JordanAceto/stereo_modulation_fx_motherboard/construction_docs/BOM.ods

Reference | Quantity | Value | Footprint | Unit Price | Total Price | Product Page
Mouser Parts
C14 C13 C12 C11 C10 C19 C18 C17 C16 C15 C22 C24 C23 C25 C20 C21 C29 C28 C39 C8 C9 C32 C33 C35 C36 C40 C41 C42 C7 C34 C43 C44 C45 | 33 | 100nF | 0805 | $0.10 | $3.30 | https://www.mouser.com/ProductDetail/KEMET/C0805C104M5RACTU
C30 C31 | 2 | 100nF | 0805 | $0.66 | $1.32 | https://www.mouser.com/ProductDetail/Panasonic/ECP-U1C104MA5
C1 C2 C3 C4 | 4 | 1uF | 0805 | $0.44 | $1.76 | https://www.mouser.com/ProductDetail/KEMET/C0805C105M5RACTU
C27 C26 C37 C38 | 4 | 10nF | 0805 | $0.30 | $1.20 | https://www.mouser.com/ProductDetail/KEMET/C0805C103J5GEC7210
C46 C47 | 2 | 22uF | 0805 | $0.66 | $1.32 | https://www.mouser.com/ProductDetail/Murata-Electronics/GRT21BR61E226ME13L
C5 C6 | 2 | 4u7 | 0805 | $0.22 | $0.44 | https://www.mouser.com/ProductDetail/TDK/C2012X7R1A475M125AC
D1 D2 | 1 | NeoPixel_THT (5 pack) | 5MM LED | $4.95 | $4.95 | https://www.mouser.com/ProductDetail/Adafruit/1938
J9 J10 J11 J12 J13 J14 | 1 | breakaway headers X 40 | PinHeader_2.54mm | $2.78 | $2.78 | https://www.mouser.com/ProductDetail/TE-Connectivity/4-103185-0
J1 J2 J3 J4 J5 J6 J7 J8 | 3 | breakaway sockets X 30 | PinSocket 2.54mm | $4.50 | $13.50 | https://www.mouser.com/ProductDetail/TE-Connectivity-AMP/7-535541-8
L2 L3 | 2 | 100uH | 0805 | ? | #VALUE!
L1 | 1 | 100uH | 0805 | ? | #VALUE!
R1 R2 | 2 | 100k | 0805 | $0.10 | $0.20 | https://www.mouser.com/ProductDetail/Bourns/CR0805-FX-1003ELF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
R11 R12 | 2 | 30k | 0805 | $0.10 | $0.20 | https://www.mouser.com/ProductDetail/Bourns/CR0805-FX-3002ELF
R13 R14 | 2 | 120k | 0805 | $0.10 | $0.20 | https://www.mouser.com/ProductDetail/Bourns/CR0805-FX-1203ELF
R15 R16 | 2 | 82k | 0805 | $0.12 | $0.24 | https://www.mouser.com/ProductDetail/Bourns/CR0805-FX-8202ELF
R17 | 1 | 15k | 0805 | $0.10 | $0.10 | https://www.mouser.com/ProductDetail/Bourns/CR0805-FX-1502ELF
R18 | 1 | 27k | 0805 | $0.10 | $0.10 | https://www.mouser.com/ProductDetail/Bourns/CR0805-FX-2702ELF
R21 R22 | 2 | 2k2 | 0805 | $0.10 | $0.20 | https://www.mouser.com/ProductDetail/Bourns/CR0805-FX-2201ELF
R3 R4 | 2 | 20k | 0805 | $0.10 | $0.20 | https://www.mouser.com/ProductDetail/Bourns/CR0805-FX-2002ELF
R6 R5 | 2 | 1M | 0805 | $0.10 | $0.20 | https://www.mouser.com/ProductDetail/Bourns/CR0805-FX-1004ELF
R7 R8 | 2 | 220 | 0805 | $0.10 | $0.20 | https://www.mouser.com/ProductDetail/Bourns/CR0805-FX-2200ELF
R9 R10 | 2 | 10k | 0805 | $0.10 | $0.20 | https://www.mouser.com/ProductDetail/Bourns/CR0805-FX-1002ELF
RV13 RV14 | 2 | 100k | Bourns_3269W_Vertical | $4.83 | $9.66 | https://www.mouser.com/ProductDetail/Bourns/3269W-1-104LF?qs=sGAEpiMZZMvygUB3GLcD7iPUMwpiXMBsQtXtzdbyTwg%3D
SW1 | 1 | sweep_mode_center_off | SPDT_on_off_on | $2.70 | $2.70 | https://www.mouser.com/ProductDetail/E-Switch/100SP3T1B1M2QEH
SW2 | 1 | invert_B | SPDT_on_on | $2.24 | $2.24 | https://www.mouser.com/ProductDetail/E-Switch/100SP1T1B1M2QEH
SW3 | 1 | B_input_selector_on_on_on | DPDT_on_on_on | $4.01 | $4.01 | https://www.mouser.com/ProductDetail/E-Switch/100DP6T1B1M2QE?qs=sGAEpiMZZMvudeGI7i40XLGgXAXfCfEjq1FnpdPcT88%3D
U1 | 1 | Teensy3.2 | teensy_3.2 | $24.93 | $24.93 | https://www.mouser.com/ProductDetail/Adafruit/2756
U10 U11 | 2 | DG419LDY | SOIC-8 | $3.88 | $7.76 | https://www.mouser.com/ProductDetail/Maxim-Integrated/DG419LDY%2B
U2 | 1 | CD74HC4067M | SOIC-24W | $0.93 | $0.93 | https://www.mouser.com/ProductDetail/Texas-Instruments/CD74HC4067M
U3 U4 | 2 | MCP4822 | SOIC-8 | $3.09 | $6.18 | https://www.mouser.com/ProductDetail/Microchip-Technology/MCP4822-E-SN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
U5 U7 | 2 | TL072 | SOIC-8 | $0.60 | $1.20 | https://www.mouser.com/ProductDetail/Texas-Instruments/TL072CDR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
U8 U6 U12 | 3 | MCP6002 | SOIC-8 | $0.33 | $0.99 | https://www.mouser.com/ProductDetail/Microchip-Technology/MCP6002T-I-SN
U9 | 1 | CC3-0512DF-E | CC3-0512DF-E | $11.21 | $11.21 | https://www.mouser.com/ProductDetail/TDK-Lambda/CC3-0512DF-E
 |  |  | Mouser Total: |  | #VALUE!
 |  |  | Link to Mouser project:
Non-Mouser Parts
RV1 RV3 RV5 RV9 RV2 RV4 RV6 RV10 | 8 | 10k linear | Alpha_RD901F-40-00D | $1.61 | $12.88 | https://www.thonk.co.uk/shop/alpha-9mm-pots/
R7 R8 RV11 RV12 | 4 | 10k linear with center detent | Alpha_RD901F-40-00D | $1.64 | $6.56 | https://www.thonk.co.uk/shop/alpha-9mm-pots/
 |  |  | Non-Mouser total: |  | $19.44
OSHPark Board
[add link here when happy with board]
