JordanAceto/stereo_modulation_fx_motherboard/construction_docs/parts_list.ods

Reference | Quantity | Value
C14 C13 C12 C11 C10 C19 C18 C17 C16 C15 C22 C24 C23 C25 C20 C21 C29 C28 C39 C8 C9 C32 C33 C35 C36 C40 C41 C42 C7 C34 C43 C44 C45 | 33 | 100nF
C30 C31 | 2 | 100nF
C1 C2 C3 C4 | 4 | 1uF
C27 C26 C37 C38 | 4 | 10nF
C46 C47 | 2 | 22uF
C5 C6 | 2 | 4u7
D1 D2 | 1 | NeoPixel_THT (5 pack)
J9 J10 J11 J12 J13 J14 | 1 | breakaway headers X 40
J1 J2 J3 J4 J5 J6 J7 J8 | 3 | breakaway sockets X 30
L2 L3 | 2 | 100uH
L1 | 1 | 100uH
R1 R2 | 2 | 100k
R11 R12 | 2 | 30k
R13 R14 | 2 | 120k
R15 R16 | 2 | 82k
R17 | 1 | 15k
R18 | 1 | 27k
R21 R22 | 2 | 2k2
R3 R4 | 2 | 20k
R6 R5 | 2 | 1M
R7 R8 | 2 | 220
R9 R10 | 2 | 10k
RV13 RV14 | 2 | 100k
SW1 | 1 | sweep_mode_center_off
SW2 | 1 | invert_B
SW3 | 1 | B_input_selector_on_on_on
U1 | 1 | Teensy3.2
U10 U11 | 2 | DG419LDY
U2 | 1 | CD74HC4067M
U3 U4 | 2 | MCP4822
U5 U7 | 2 | TL072
U8 U6 U12 | 3 | MCP6002
U9 | 1 | CC3-0512DF-E
RV1 RV3 RV5 RV9 RV2 RV4 RV6 RV10 | 8 | 10k linear
R7 R8 RV11 RV12 | 4 | 10k linear with center detent
