JordanAceto/stereo_modulation_fx_motherboard/(threads)

Thread 1 (2019-07-18):

B-input switch is backwards on pcb

JordanAceto, 2019-07-18:
DPDT on-on-on switch is mirrored vertically on pcb.

to fix: change footprint in .pretty file and re-route pcb

Thread 2 (2019-07-18):

all pots are backwards on pcb

JordanAceto, 2019-07-18:
All pots reach +3.3v at full CCW and 0v at full CW.

This is currently accounted for in the firmware by inverting all of the pot signals as they are read by the ADC, but it would be nice to have them go the right way in a future board rev.

To fix: flip all the pots in the schematic and re-route the pcb.

Thread 3 (2019-07-18):

The silkscreen for env A trim and env B trim are reversed

JordanAceto, 2019-07-18:
To fix: swap the silkscreen notes on the pcb

Thread 4 (2019-07-18):

The silkscreen for L3 and C25 reversed

JordanAceto, 2019-07-18:
This is a bad issue. If the board is build according to the silkscreen the -12v rail will be shorted to ground through L3.

To fix: swap the silkscreen designators on the pcb.

Thread 5 (2019-07-18):

footprints for all inductors are wrong

JordanAceto, 2019-07-18:
The footprints for all the inductors do not match the inductors in the BOM. Power filtering needs to be improved in general.

On the current board 600 ohm ferrite beads are installed @ L1, L2, and L3.
