JordanAceto/stereo_modulation_fx_motherboard/construction_docs/schematic.pdf

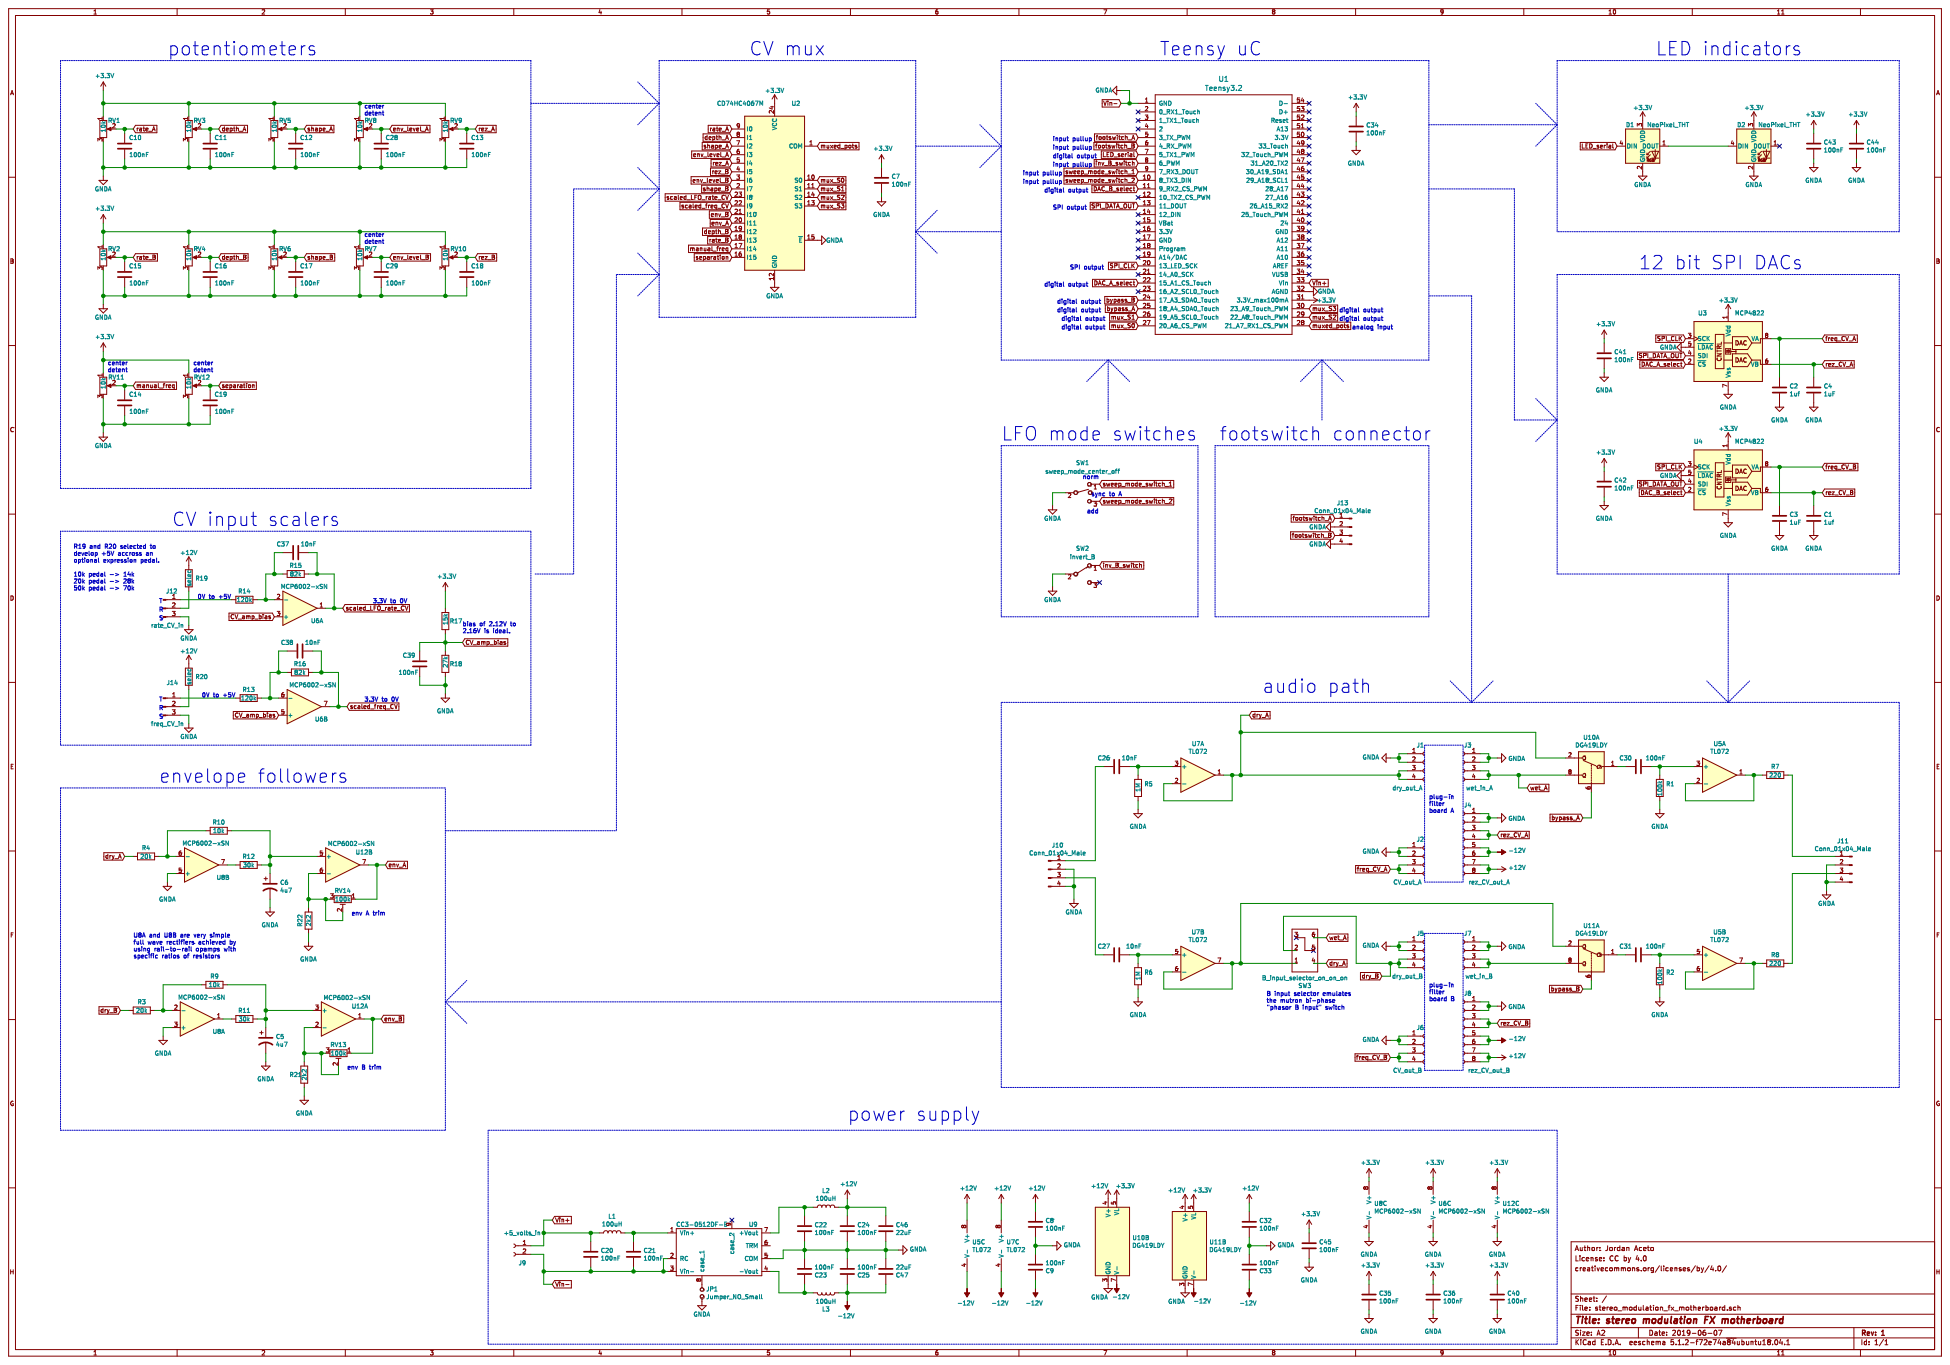
[picture p1: page 1]
