JordanAceto/stereo_modulation_fx_motherboard/kicad_docs/stereo_modulation_fx_motherboard.kicad_pcb

## KiCad design kicad_docs/stereo_modulation_fx_motherboard.kicad_pcb (2019-06-21)

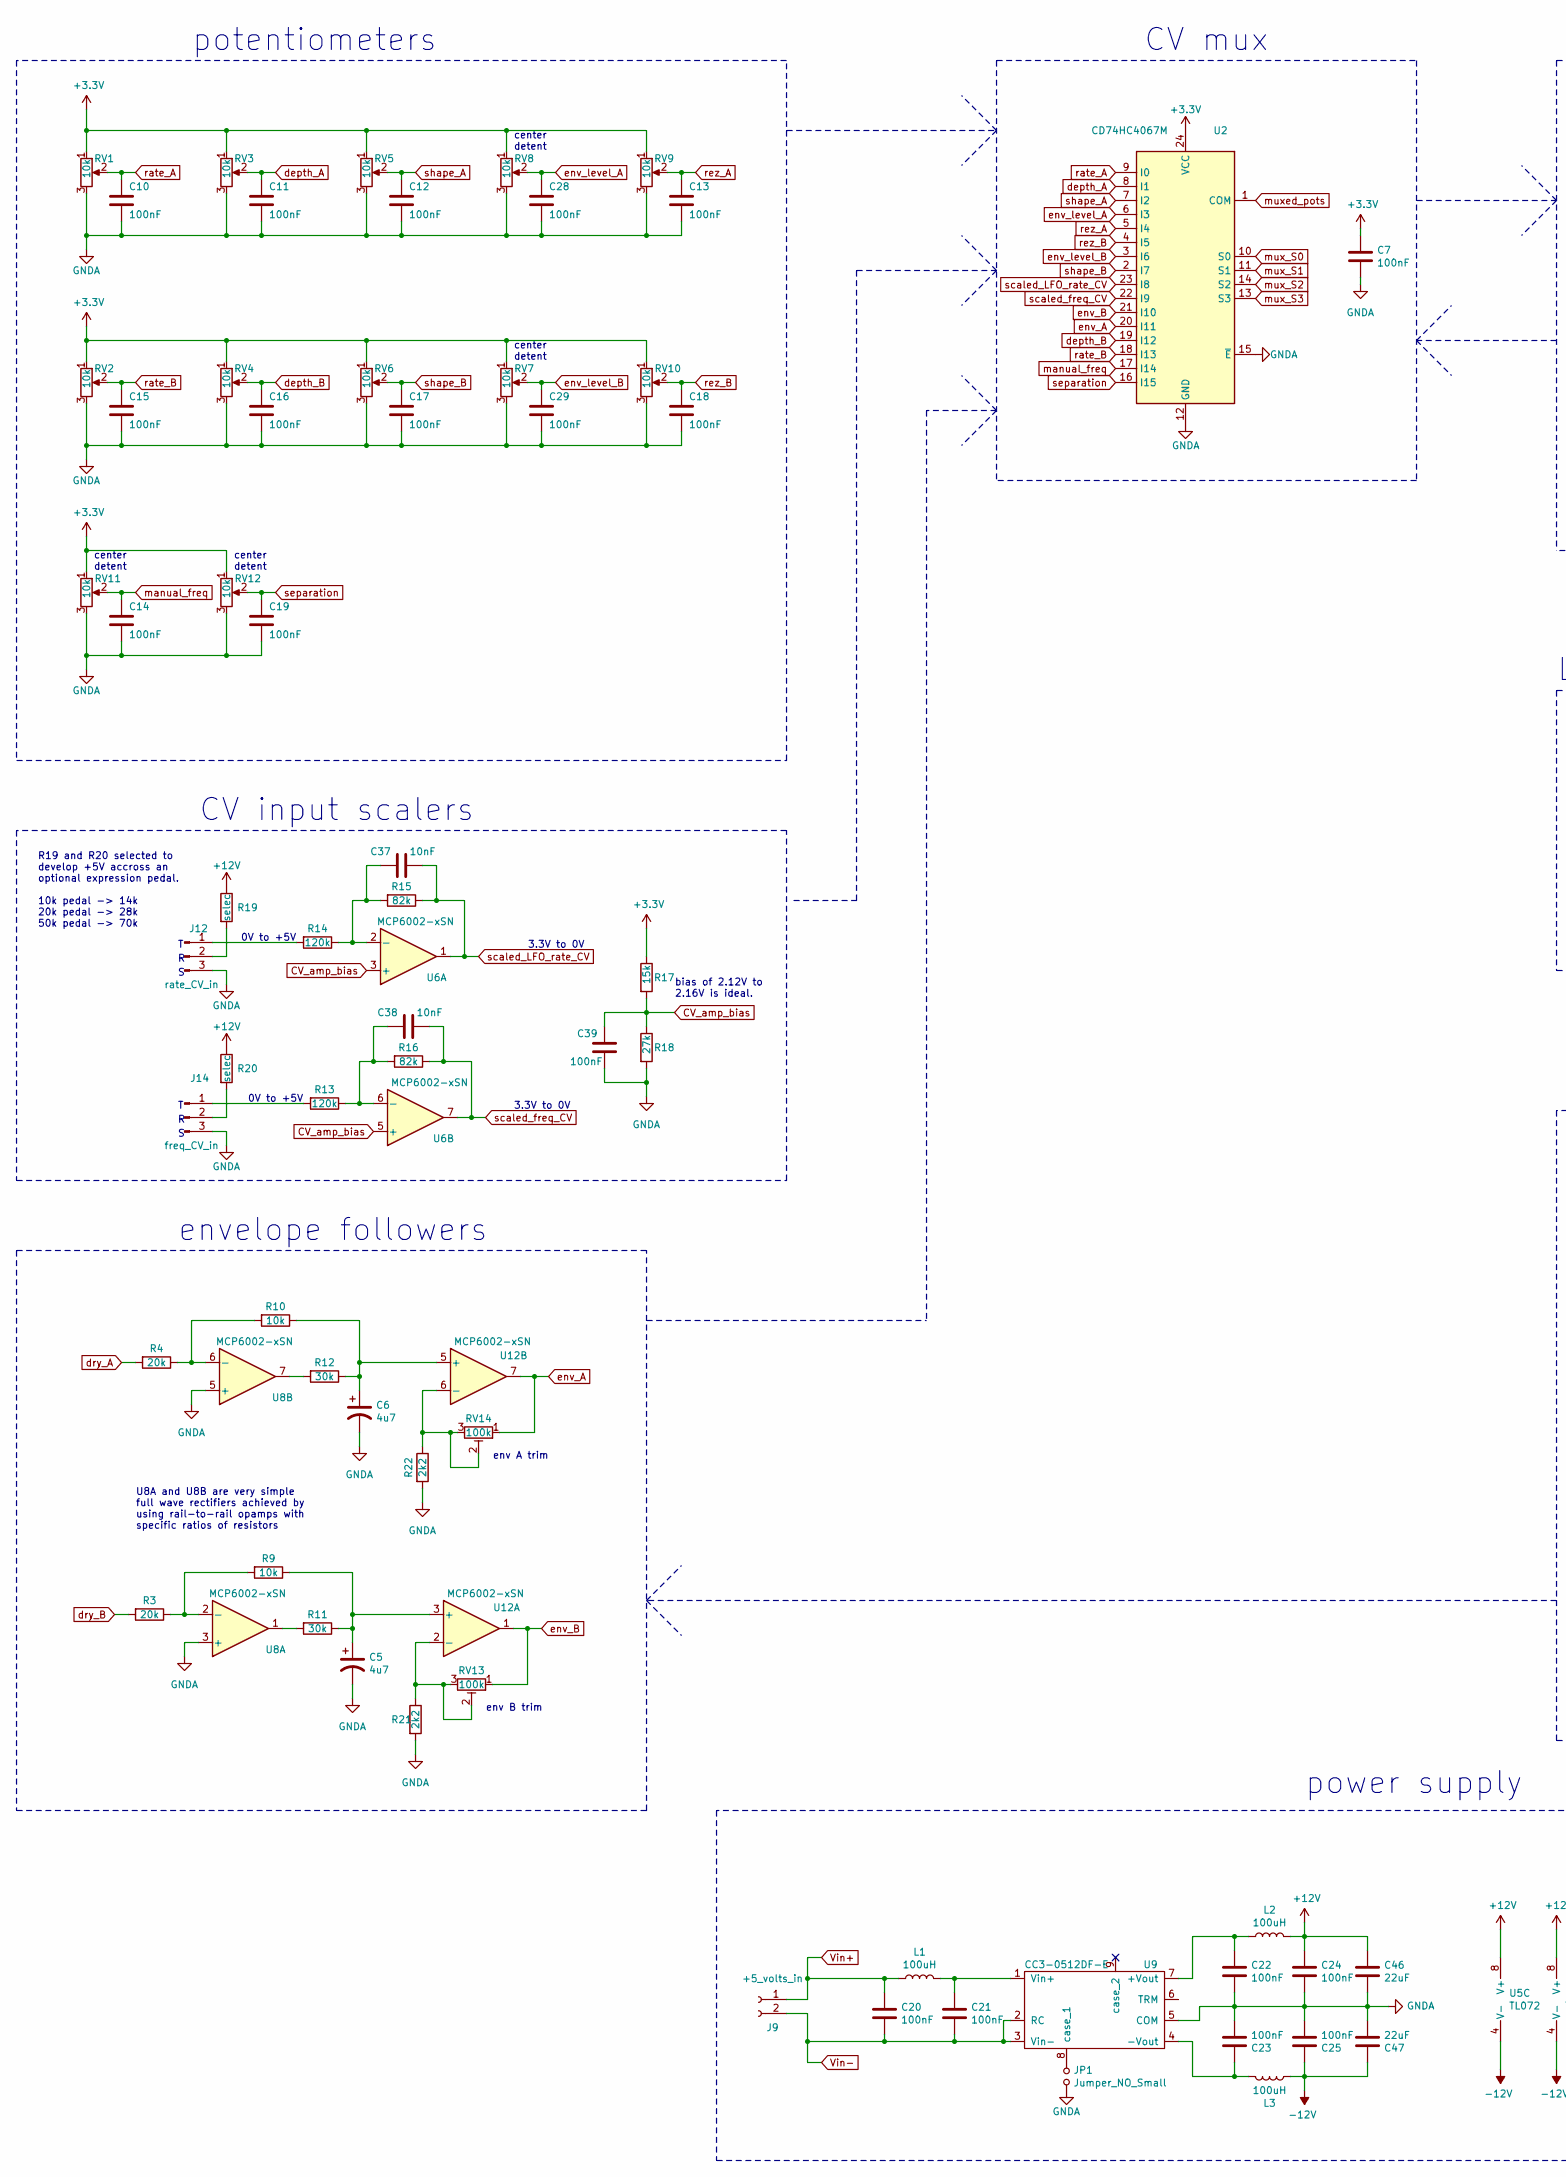
[picture p2: schematic stereo_modulation_fx_motherboard.sch, stereo modulation FX motherboard, part in row 1, column 1]

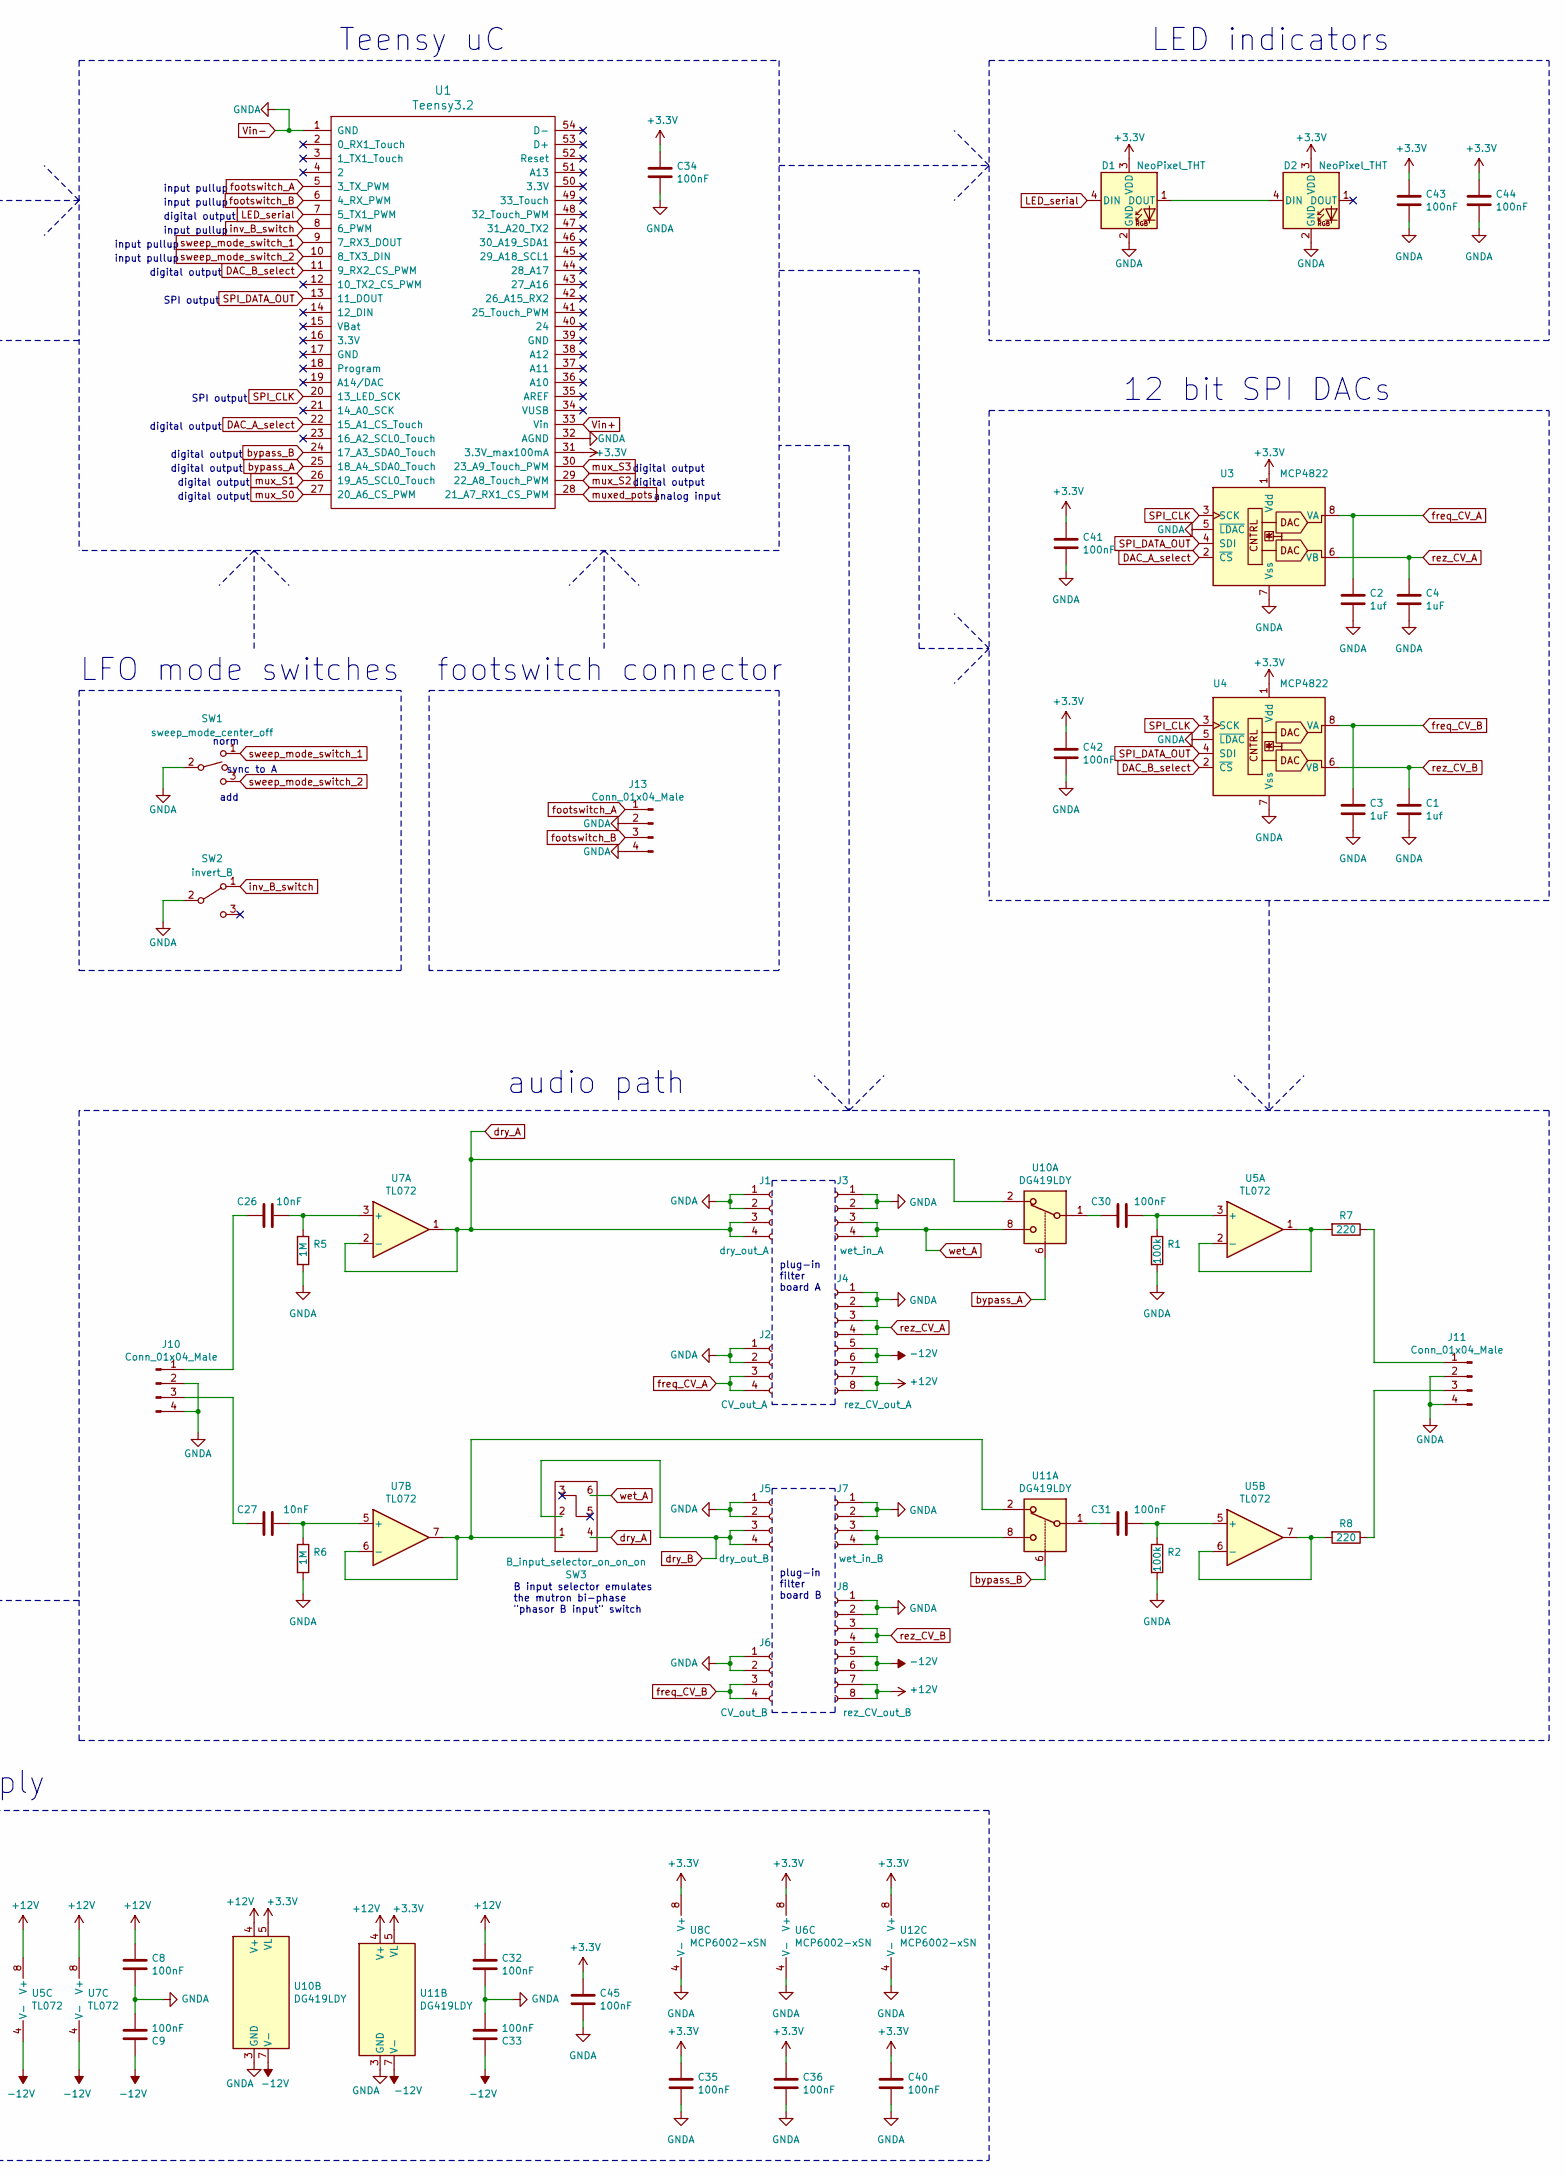
[picture p3: schematic stereo_modulation_fx_motherboard.sch, stereo modulation FX motherboard, part in row 1, column 2]

Parts:
C1, C2: 1uf; C_0805_2012Metric_Pad1.15x1.40mm_HandSolder
C3, C4: 1uF; C_0805_2012Metric_Pad1.15x1.40mm_HandSolder
C5, C6: 4u7; C_0805_2012Metric_Pad1.15x1.40mm_HandSolder
C7, C8, C9, C10, C11, C12, C13, C14, C15, C16, C17, C18, C19, C20, C21, C22, C23, C24, C25, C28, C29, C30, C31, C32, C33, C34, C35, C36, C39, C40, C41, C42, C43, C44, C45: 100nF; C_0805_2012Metric_Pad1.15x1.40mm_HandSolder
C26, C27, C37, C38: 10nF; C_0805_2012Metric_Pad1.15x1.40mm_HandSolder
C46, C47: 22uF; C_0805_2012Metric_Pad1.15x1.40mm_HandSolder
D1, D2: NeoPixel_THT; LED_D5.0mm-4_RGB
J1: dry_out_A; PinSocket_1x04_P2.54mm_Vertical
J2: CV_out_A; PinSocket_1x04_P2.54mm_Vertical
J3: wet_in_A; PinSocket_1x04_P2.54mm_Vertical
J4: rez_CV_out_A; PinSocket_1x08_P2.54mm_Vertical
J5: dry_out_B; PinSocket_1x04_P2.54mm_Vertical
J6: CV_out_B; PinSocket_1x04_P2.54mm_Vertical
J7: wet_in_B; PinSocket_1x04_P2.54mm_Vertical
J8: rez_CV_out_B; PinSocket_1x08_P2.54mm_Vertical
J9: +5_volts_in; PinHeader_1x02_P2.54mm_Vertical
J10, J11, J13: Conn_01x04_Male; PinHeader_1x04_P2.54mm_Vertical
J12: rate_CV_in; PinHeader_1x03_P2.54mm_Vertical
J14: freq_CV_in; PinHeader_1x03_P2.54mm_Vertical
JP1: Jumper_NO_Small; SolderJumper-2_P1.3mm_Open_RoundedPad1.0x1.5mm
L1, L2, L3: 100uH; L_0805_2012Metric_Pad1.15x1.40mm_HandSolder
R1, R2: 100k; R_0805_2012Metric_Pad1.15x1.40mm_HandSolder
R3, R4: 20k; R_0805_2012Metric_Pad1.15x1.40mm_HandSolder
R5, R6: 1M; R_0805_2012Metric_Pad1.15x1.40mm_HandSolder
R7, R8: 220; R_0805_2012Metric_Pad1.15x1.40mm_HandSolder
R9, R10: 10k; R_0805_2012Metric_Pad1.15x1.40mm_HandSolder
R11, R12: 30k; R_0805_2012Metric_Pad1.15x1.40mm_HandSolder
R13, R14: 120k; R_0805_2012Metric_Pad1.15x1.40mm_HandSolder
R15, R16: 82k; R_0805_2012Metric_Pad1.15x1.40mm_HandSolder
R17: 15k; R_0805_2012Metric_Pad1.15x1.40mm_HandSolder
R18: 27k; R_0805_2012Metric_Pad1.15x1.40mm_HandSolder
R19, R20: selec; R_0805_2012Metric_Pad1.15x1.40mm_HandSolder
R21, R22: 2k2; R_0805_2012Metric_Pad1.15x1.40mm_HandSolder
RV1, RV2, RV3, RV4, RV5, RV6, RV7, RV8, RV9, RV10, RV11, RV12: 10k; Potentiometer_Alpha_RD901F-40-00D_Single_Vertical_CircularH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
RV13, RV14: 100k; Potentiometer_Bourns_3269W_Vertical
SW1: sweep_mode_center_off; SPDT_on_on
SW2: invert_B; SPDT_on_on
SW3: B_input_selector_on_on_on; DPDT_on_on_on
U1: Teensy3.2; teensy_3.2
U2: CD74HC4067M; SOIC-24W_7.5x15.4mm_P1.27mm
U3, U4: MCP4822; SOIC-8_3.9x4.9mm_P1.27mm
U5, U7: TL072; SOIC-8_3.9x4.9mm_P1.27mm
U6, U8, U12: MCP6002-xSN; SOIC-8_3.9x4.9mm_P1.27mm
U9: CC3-0512DF-E
U10, U11: DG419LDY; SOIC-8_3.9x4.9mm_P1.27mm

Connections:
+3V3: C7.1, C34.1, C35.1, C36.1, C40.1, C41.1, C42.1, C43.1, C44.1, C45.1, D1.3 (VDD), D2.3 (VDD), R17.1, RV1.1, RV2.1, RV3.1, RV4.1, RV5.1, RV6.1, RV7.1, RV8.1, RV9.1, RV10.1, RV11.1, RV12.1, U1.31 (3.3V_max100mA), U2.24 (VCC), U3.1 (Vdd), U4.1 (Vdd), U6.8 (V+), U8.8 (V+), U10.5 (VL), U11.5 (VL), U12.8 (V+)
+12V: C8.1, C24.1, C32.1, C46.1, J4.7, J4.8, J8.7, J8.8, L2.2, R19.1, R20.1, U5.8 (V+), U7.8 (V+), U10.4 (V+), U11.4 (V+)
-12V: C9.1, C25.1, C33.1, C47.1, J4.5, J4.6, J8.5, J8.6, L3.2, U5.4 (V-), U7.4 (V-), U10.7 (V-), U11.7 (V-)
CV_amp_bias: C39.1, R17.2, R18.1, U6.3 (+), U6.5 (+)
DAC_A_select: U1.22 (15_A1_CS_Touch), U3.2 (~CS)
DAC_B_select: U1.11 (9_RX2_CS_PWM), U4.2 (~CS)
LED_serial: D1.4 (DIN), U1.7 (5_TX1_PWM)
LFO_rate_CV_in: J12.1, R14.2
unnamed: C5.1, R9.1, R11.1, U12.3 (+)
unnamed: C6.1, R10.1, R12.1, U12.5 (+)
unnamed: C21.1, L1.2, U9.1 (Vin+)
unnamed: C22.1, L2.1, U9.7 (+Vout)
unnamed: C23.1, L3.1, U9.4 (-Vout)
unnamed: C26.1, R5.1, U7.3 (+)
unnamed: C26.2, J10.1
unnamed: C27.1, R6.1, U7.5 (+)
unnamed: C27.2, J10.3
unnamed: C30.1, R1.1, U5.3 (+)
unnamed: C30.2, U10.1
unnamed: C31.1, R2.1, U5.5 (+)
unnamed: C31.2, U11.1
unnamed: C37.2, R14.1, R15.2, U6.2 (-)
unnamed: C38.2, R13.1, R16.2, U6.6 (-)
unnamed: D1.1 (DOUT), D2.4 (DIN)
unnamed: J7.3, J7.4, U11.8
unnamed: J11.1, R7.1
unnamed: J11.3, R8.1
unnamed: J12.2, R19.2
unnamed: J14.2, R20.2
unnamed: JP1.1, U9.8 (case_1)
unnamed: R3.1, R9.2, U8.2 (-)
unnamed: R7.2, U5.1, U5.2 (-)
unnamed: R8.2, U5.6 (-), U5.7
unnamed: R4.1, R10.2, U8.6 (-)
unnamed: R11.2, U8.1
unnamed: R12.2, U8.7
unnamed: R21.1, RV13.2, RV13.3, U12.2 (-)
unnamed: R22.1, RV14.2, RV14.3, U12.6 (-)
unnamed: SW3.1, U7.6 (-), U7.7, U11.2
SPI_CLK: U1.20 (13_LED_SCK), U3.3 (SCK), U4.3 (SCK)
SPI_DATA_OUT: U1.13 (11_DOUT), U3.4 (SDI), U4.4 (SDI)
Vin+: C20.1, J9.1, L1.1, U1.33 (Vin)
Vin-: C1.2, C2.2, C3.2, C4.2, C5.2, C6.2, C7.2, C8.2, C9.2, C10.2, C11.2, C12.2, C13.2, C14.2, C15.2, C16.2, C17.2, C18.2, C19.2, C20.2, C21.2, C22.2, C23.2, C24.2, C25.2, C28.2, C29.2, C32.2, C33.2, C34.2, C35.2, C36.2, C39.2, C40.2, C41.2, C42.2, C43.2, C44.2, C45.2, C46.2, C47.2, D1.2 (GND), D2.2 (GND), J1.1, J1.2, J2.1, J2.2, J3.1, J3.2, J4.1, J4.2, J5.1, J5.2, J6.1, J6.2, J7.1, J7.2, J8.1, J8.2, J9.2, J10.2, J10.4, J11.2, J11.4, J12.3, J13.2, J13.4, J14.3, JP1.2, R1.2, R2.2, R5.2, R6.2, R18.2, R21.2, R22.2, RV1.3, RV2.3, RV3.3, RV4.3, RV5.3, RV6.3, RV7.3, RV8.3, RV9.3, RV10.3, RV11.3, RV12.3, SW1.2, SW2.2 (B), U1.1 (GND), U1.32 (AGND), U2.12 (GND), U2.15 (~E), U3.5 (~LDAC), U3.7 (Vss), U4.5 (~LDAC), U4.7 (Vss), U6.4 (V-), U8.3 (+), U8.4 (V-), U8.5 (+), U9.2 (RC), U9.3 (Vin-), U9.5 (COM), U10.3 (GND), U11.3 (GND), U12.4 (V-)
bypass_A: U1.25 (18_A4_SDA0_Touch), U10.6
bypass_B: U1.24 (17_A3_SDA0_Touch), U11.6
depth_A: C11.1, RV3.2, U2.8 (I1)
depth_B: C16.1, RV4.2, U2.19 (I12)
dry_A: J1.3, J1.4, R4.2, SW3.4, U7.1, U7.2 (-), U10.2
dry_B: J5.3, J5.4, R3.2, SW3.2
env_A: RV14.1, U2.20 (I11), U12.7
env_B: RV13.1, U2.21 (I10), U12.1
env_level_A: C28.1, RV8.2, U2.6 (I3)
env_level_B: C29.1, RV7.2, U2.3 (I6)
footswitch_A: J13.1, U1.5 (3_TX_PWM)
footswitch_B: J13.3, U1.6 (4_RX_PWM)
freq_CV_A: C2.1, J2.3, J2.4, U3.8 (VA)
freq_CV_B: C3.1, J6.3, J6.4, U4.8 (VA)
freq_CV_in: J14.1, R13.2
inv_B_switch: SW2.1 (A), U1.8 (6_PWM)
manual_freq: C14.1, RV11.2, U2.17 (I14)
mux_S0: U1.27 (20_A6_CS_PWM), U2.10 (S0)
mux_S1: U1.26 (19_A5_SCL0_Touch), U2.11 (S1)
mux_S2: U1.29 (22_A8_Touch_PWM), U2.14 (S2)
mux_S3: U1.30 (23_A9_Touch_PWM), U2.13 (S3)
muxed_pots: U1.28 (21_A7_RX1_CS_PWM), U2.1 (COM)
rate_A: C10.1, RV1.2, U2.9 (I0)
rate_B: C15.1, RV2.2, U2.18 (I13)
rez_A: C13.1, RV9.2, U2.5 (I4)
rez_B: C18.1, RV10.2, U2.4 (I5)
rez_CV_A: C4.1, J4.3, J4.4, U3.6 (VB)
rez_CV_B: C1.1, J8.3, J8.4, U4.6 (VB)
scaled_LFO_rate_CV: C37.1, R15.1, U2.23 (I8), U6.1
scaled_freq_CV: C38.1, R16.1, U2.22 (I9), U6.7
separation: C19.1, RV12.2, U2.16 (I15)
shape_A: C12.1, RV5.2, U2.7 (I2)
shape_B: C17.1, RV6.2, U2.2 (I7)
sweep_mode_switch_1: SW1.1, U1.9 (7_RX3_DOUT)
sweep_mode_switch_2: SW1.3, U1.10 (8_TX3_DIN)
wet_A: J3.3, J3.4, SW3.6, U10.8

Notes on the sheet:
norm
sync to A
add
0V to +5V
3.3V to 0V
envelope followers
CV input scalers
audio path
potentiometers
12 bit SPI DACs
LFO mode switches
CV mux
footswitch connector
input pullup
digital output
analog input
SPI output
LED indicators
bias of 2.12V to 2.16V is ideal.
Teensy uC
power supply
center detent
R19 and R20 selected to develop +5V accross an optional expression pedal. 10k pedal -> 14k 20k pedal -> 28k 50k pedal -> 70k
env A trim
env B trim
U8A and U8B are very simple full wave rectifiers achieved by using rail-to-rail opamps with specific ratios of resistors
B input selector emulates the mutron bi-phase "phasor B input" switch
plug-in filter board A
plug-in filter board B

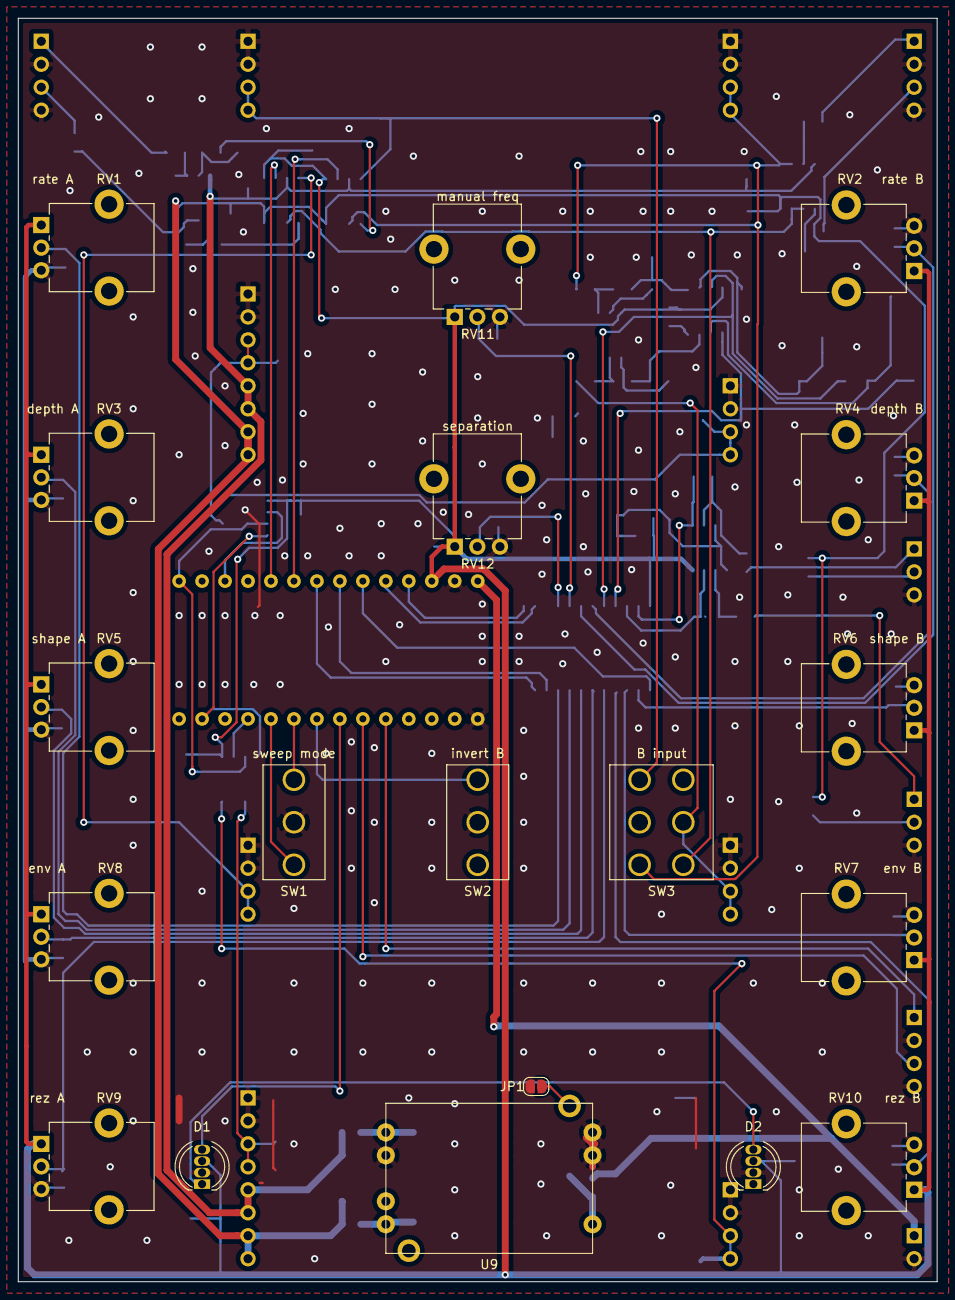
[picture p4: board stereo_modulation_fx_motherboard.kicad_pcb from above]

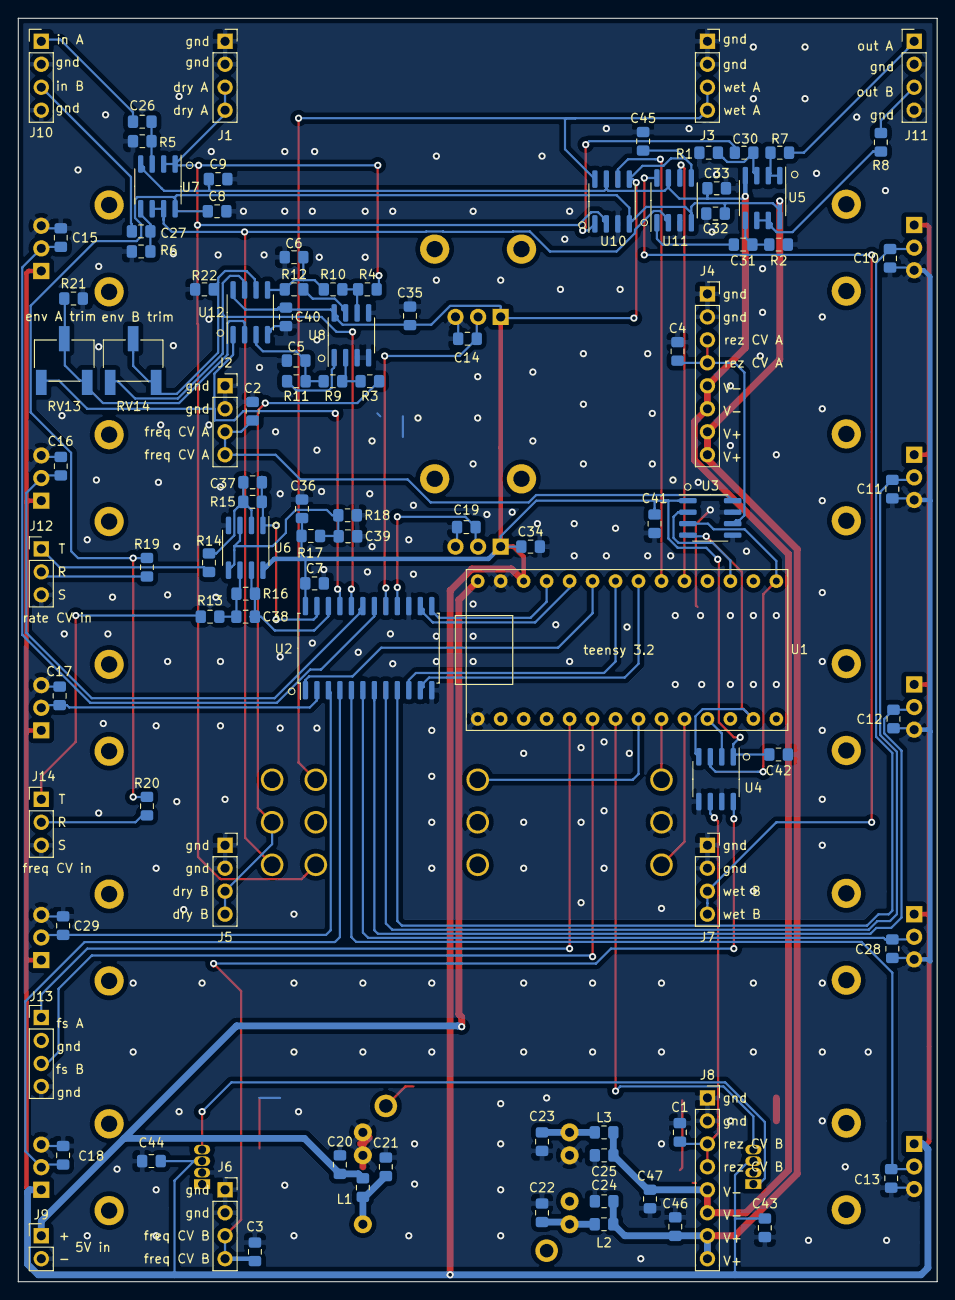
[picture p5: board stereo_modulation_fx_motherboard.kicad_pcb from below]

Board: 2 copper layers, 101.6 x 139.7 mm, 118 parts (99 on the bottom side), 79 nets.
