JordanAceto/stereo_modulation_fx_motherboard/(commit log)

2019-05-23 initial commit, NOT DONE! DO NOT ORDER BOARDS!
    [stereo_modulation_fx_motherboard.kicad_pcb, stereo_modulation_fx_motherboard.sch]
2019-05-24 add note about wet/dry mix polarity to schem, will need to be addressed
    [stereo_modulation_fx_motherboard.sch]
2019-05-25 add wet/dry mix inverter, tidy up board, NOT DONE DO NOT ORDER BOARDS!
    [stereo_modulation_fx_motherboard.kicad_pcb, stereo_modulation_fx_motherboard.sch]
2019-05-25 add input buffers, misc tidy up, NOT DONE DO NOT ORDER BOARDS!
    [stereo_modulation_fx_motherboard.kicad_pcb, stereo_modulation_fx_motherboard.sch]
2019-05-26 change DACs to MCP4822, misc tidy up, DO NOT ORDER BOARDS!
    [stereo_modulation_fx_motherboard.kicad_pcb, stereo_modulation_fx_motherboard.sch]
2019-05-27 remove wet/dry mixer, replace with envelope follower, NOT DONE DO NOT ORDER BOARDS!
    [stereo_modulation_fx_motherboard.kicad_pcb, stereo_modulation_fx_motherboard.sch]
2019-05-28 continue working on layout, NOT DONE!
    [stereo_modulation_fx_motherboard.kicad_pcb, stereo_modulation_fx_motherboard.sch]
2019-05-30 move all components to one side of board, play with trace layout, NOT DONEgit add -A!
    [stereo_modulation_fx_motherboard.kicad_pcb, stereo_modulation_fx_motherboard.sch]
2019-05-31 move traces/vias away from pot tabs, progress on routing, NOT DONEgit add -A!
    [stereo_modulation_fx_motherboard.kicad_pcb, stereo_modulation_fx_motherboard.sch]
2019-05-31 move schematic blocks around, add LEDs
    [stereo_modulation_fx_motherboard.kicad_pcb, stereo_modulation_fx_motherboard.sch]
2019-06-05 plug in boards are smaller now
    [stereo_modulation_fx_motherboard.kicad_pcb, stereo_modulation_fx_motherboard.sch]
2019-06-06 tidy schematic, add stitching vias
    [stereo_modulation_fx_motherboard.kicad_pcb, stereo_modulation_fx_motherboard.sch]
2019-06-07 restrucure files, begin firmware
    [stereo_modulation_fx_motherboard.kicad_pcb, stereo_modulation_fx_motherboard.sch]
2019-06-07 begin BOM, add pdf of schematic
    [BOM.ods, stereo_modulation_fx_motherboard.sch]
2019-06-07 fill in BOM
    [BOM.ods]
2019-06-07 refine BOM
    [BOM.ods]
2019-06-07 tidy up BOM
    [BOM.ods]
2019-06-10 correct BOM mistake, more BOM errors probably lurk
    [BOM.ods]
2019-06-10 work on BOM, inductors are still wrong
    [BOM.ods]
2019-06-15 add parts list to construction docs
    [parts_list.ods]
2019-06-15 mess around with firmware after getting rev 1 board
2019-06-15 minor changes to pcb
    [stereo_modulation_fx_motherboard.kicad_pcb]
2019-06-21 add to list of probs with rev 1 board
2019-06-21 add crosshair drill marks to pcb user drawings
    [stereo_modulation_fx_motherboard.kicad_pcb]
