JordanAceto/stereo_modulation_fx_motherboard/(notices)

Notices in the files:
kicad_docs/stereo_modulation_fx_motherboard.sch:
creativecommons.org/licenses/by/4.0
License: CC by 4.0
